wdxzf/E-Race-AutoCar-/README.md

# E-Race-AutoCar-
2024电赛自动行驶小车│电子设计大赛一等奖（湖南第三）
