wdxzf/E-Race-AutoCar-/源码/user/user/MSPM0G3507_IMU660_Demo/BSP/motor.h

#ifndef _MOTOR_H_
#define _MOTOR_H_
#include "headfile.h"

#define PulseMPS 0.014 //轮轴系数
typedef struct
{
    float Lenth;       //距离  防抖
} Step;/***************距离***************/

int16_t Speed_Get(void);
void motor_turn(int32_t speedL,int32_t speedR);

extern Step Step1;
#endif
