wdxzf/E-Race-AutoCar-/源码/user/user/MSPM0G3507_IMU660_Demo/ti_msp_dl_config.c

/*
 * Copyright (c) 2023, Texas Instruments Incorporated
 * All rights reserved.
 *
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
 * *  Redistributions of source code must retain the above copyright
 *    notice, this list of conditions and the following disclaimer.
 *
 * *  Redistributions in binary form must reproduce the above copyright
 *    notice, this list of conditions and the following disclaimer in the
 *    documentation and/or other materials provided with the distribution.
 *
 * *  Neither the name of Texas Instruments Incorporated nor the names of
 *    its contributors may be used to endorse or promote products derived
 *    from this software without specific prior written permission.
 *
 * THIS SOFTWARE IS PROVIDED BY THE COPYRIGHT HOLDERS AND CONTRIBUTORS "AS IS"
 * AND ANY EXPRESS OR IMPLIED WARRANTIES, INCLUDING, BUT NOT LIMITED TO,
 * THE IMPLIED WARRANTIES OF MERCHANTABILITY AND FITNESS FOR A PARTICULAR
 * PURPOSE ARE DISCLAIMED. IN NO EVENT SHALL THE COPYRIGHT OWNER OR
 * CONTRIBUTORS BE LIABLE FOR ANY DIRECT, INDIRECT, INCIDENTAL, SPECIAL,
 * EXEMPLARY, OR CONSEQUENTIAL DAMAGES (INCLUDING, BUT NOT LIMITED TO,
 * PROCUREMENT OF SUBSTITUTE GOODS OR SERVICES; LOSS OF USE, DATA, OR PROFITS;
 * OR BUSINESS INTERRUPTION) HOWEVER CAUSED AND ON ANY THEORY OF LIABILITY,
 * WHETHER IN CONTRACT, STRICT LIABILITY, OR TORT (INCLUDING NEGLIGENCE OR
 * OTHERWISE) ARISING IN ANY WAY OUT OF THE USE OF THIS SOFTWARE,
 * EVEN IF ADVISED OF THE POSSIBILITY OF SUCH DAMAGE.
 */

/*
 *  ============ ti_msp_dl_config.c =============
 *  Configured MSPM0 DriverLib module definitions
 *
 *  DO NOT EDIT - This file is generated for the MSPM0G350X
 *  by the SysConfig tool.
 */

#include "ti_msp_dl_config.h"

DL_SPI_backupConfig gSPI_FOR_IMUBackup;

/*
 *  ======== SYSCFG_DL_init ========
 *  Perform any initialization needed before using any board APIs
 */
SYSCONFIG_WEAK void SYSCFG_DL_init(void)
{
    SYSCFG_DL_initPower();
    SYSCFG_DL_GPIO_init();
    /* Module-Specific Initializations*/
    SYSCFG_DL_SYSCTL_init();
    SYSCFG_DL_PWM_Motor_init();
    SYSCFG_DL_TIMER_0_init();
    SYSCFG_DL_UART_0_init();
    SYSCFG_DL_SPI_FOR_IMU_init();
    SYSCFG_DL_SYSTICK_init();
    /* Ensure backup structures have no valid state */



	gSPI_FOR_IMUBackup.backupRdy 	= false;

}
/*
 * User should take care to save and restore register configuration in application.
 * See Retention Configuration section for more details.
 */
SYSCONFIG_WEAK bool SYSCFG_DL_saveConfiguration(void)
{
    bool retStatus = true;

	retStatus &= DL_SPI_saveConfiguration(SPI_FOR_IMU_INST, &gSPI_FOR_IMUBackup);

    return retStatus;
}


SYSCONFIG_WEAK bool SYSCFG_DL_restoreConfiguration(void)
{
    bool retStatus = true;

	retStatus &= DL_SPI_restoreConfiguration(SPI_FOR_IMU_INST, &gSPI_FOR_IMUBackup);

    return retStatus;
}

SYSCONFIG_WEAK void SYSCFG_DL_initPower(void)
{
    DL_GPIO_reset(GPIOA);
    DL_GPIO_reset(GPIOB);
    DL_TimerG_reset(PWM_Motor_INST);
    DL_TimerG_reset(TIMER_0_INST);
    DL_UART_Main_reset(UART_0_INST);
    DL_SPI_reset(SPI_FOR_IMU_INST);


    DL_GPIO_enablePower(GPIOA);
    DL_GPIO_enablePower(GPIOB);
    DL_TimerG_enablePower(PWM_Motor_INST);
    DL_TimerG_enablePower(TIMER_0_INST);
    DL_UART_Main_enablePower(UART_0_INST);
    DL_SPI_enablePower(SPI_FOR_IMU_INST);

    delay_cycles(POWER_STARTUP_DELAY);
}

SYSCONFIG_WEAK void SYSCFG_DL_GPIO_init(void)
{

    DL_GPIO_initPeripheralOutputFunction(GPIO_PWM_Motor_C0_IOMUX,GPIO_PWM_Motor_C0_IOMUX_FUNC);
    DL_GPIO_enableOutput(GPIO_PWM_Motor_C0_PORT, GPIO_PWM_Motor_C0_PIN);
    DL_GPIO_initPeripheralOutputFunction(GPIO_PWM_Motor_C1_IOMUX,GPIO_PWM_Motor_C1_IOMUX_FUNC);
    DL_GPIO_enableOutput(GPIO_PWM_Motor_C1_PORT, GPIO_PWM_Motor_C1_PIN);

    DL_GPIO_initPeripheralOutputFunction(
        GPIO_UART_0_IOMUX_TX, GPIO_UART_0_IOMUX_TX_FUNC);
    DL_GPIO_initPeripheralInputFunction(
        GPIO_UART_0_IOMUX_RX, GPIO_UART_0_IOMUX_RX_FUNC);

    DL_GPIO_initPeripheralOutputFunction(
        GPIO_SPI_FOR_IMU_IOMUX_SCLK, GPIO_SPI_FOR_IMU_IOMUX_SCLK_FUNC);
    DL_GPIO_initPeripheralOutputFunction(
        GPIO_SPI_FOR_IMU_IOMUX_PICO, GPIO_SPI_FOR_IMU_IOMUX_PICO_FUNC);
    DL_GPIO_initPeripheralInputFunction(
        GPIO_SPI_FOR_IMU_IOMUX_POCI, GPIO_SPI_FOR_IMU_IOMUX_POCI_FUNC);
    DL_GPIO_initPeripheralOutputFunction(
        GPIO_SPI_FOR_IMU_IOMUX_CS0, GPIO_SPI_FOR_IMU_IOMUX_CS0_FUNC);

    DL_GPIO_initDigitalOutput(SPI_FOR_IMU_CS_PIN_8_IOMUX);

    DL_GPIO_initDigitalOutput(PROTA_BEEP_IOMUX);

    DL_GPIO_initDigitalInputFeatures(KEY_key1_IOMUX,
		 DL_GPIO_INVERSION_DISABLE, DL_GPIO_RESISTOR_PULL_UP,
		 DL_GPIO_HYSTERESIS_DISABLE, DL_GPIO_WAKEUP_DISABLE);

    DL_GPIO_initDigitalInputFeatures(KEY_key2_IOMUX,
		 DL_GPIO_INVERSION_DISABLE, DL_GPIO_RESISTOR_PULL_DOWN,
		 DL_GPIO_HYSTERESIS_DISABLE, DL_GPIO_WAKEUP_DISABLE);

    DL_GPIO_initDigitalInputFeatures(KEY_key3_IOMUX,
		 DL_GPIO_INVERSION_DISABLE, DL_GPIO_RESISTOR_PULL_UP,
		 DL_GPIO_HYSTERESIS_DISABLE, DL_GPIO_WAKEUP_DISABLE);

    DL_GPIO_initDigitalInputFeatures(KEY_key4_IOMUX,
		 DL_GPIO_INVERSION_DISABLE, DL_GPIO_RESISTOR_PULL_UP,
		 DL_GPIO_HYSTERESIS_DISABLE, DL_GPIO_WAKEUP_DISABLE);

    DL_GPIO_initDigitalInputFeatures(KEY_key5_IOMUX,
		 DL_GPIO_INVERSION_DISABLE, DL_GPIO_RESISTOR_PULL_UP,
		 DL_GPIO_HYSTERESIS_DISABLE, DL_GPIO_WAKEUP_DISABLE);

    DL_GPIO_initDigitalInputFeatures(KEY_key6_IOMUX,
		 DL_GPIO_INVERSION_DISABLE, DL_GPIO_RESISTOR_PULL_UP,
		 DL_GPIO_HYSTERESIS_DISABLE, DL_GPIO_WAKEUP_DISABLE);

    DL_GPIO_initDigitalInputFeatures(KEY_key7_IOMUX,
		 DL_GPIO_INVERSION_DISABLE, DL_GPIO_RESISTOR_PULL_UP,
		 DL_GPIO_HYSTERESIS_DISABLE, DL_GPIO_WAKEUP_DISABLE);

    DL_GPIO_initDigitalInputFeatures(KEY_key8_IOMUX,
		 DL_GPIO_INVERSION_DISABLE, DL_GPIO_RESISTOR_PULL_UP,
		 DL_GPIO_HYSTERESIS_DISABLE, DL_GPIO_WAKEUP_DISABLE);

    DL_GPIO_initDigitalOutput(Motor_L2_IOMUX);

    DL_GPIO_initDigitalOutput(Motor_L1_IOMUX);

    DL_GPIO_initDigitalOutput(Motor_R1_IOMUX);

    DL_GPIO_initDigitalOutput(Motor_R2_IOMUX);

    DL_GPIO_initDigitalInputFeatures(Gray_Gray_0_IOMUX,
		 DL_GPIO_INVERSION_DISABLE, DL_GPIO_RESISTOR_PULL_UP,
		 DL_GPIO_HYSTERESIS_DISABLE, DL_GPIO_WAKEUP_DISABLE);

    DL_GPIO_initDigitalInputFeatures(Gray_Gray_1_IOMUX,
		 DL_GPIO_INVERSION_DISABLE, DL_GPIO_RESISTOR_PULL_UP,
		 DL_GPIO_HYSTERESIS_DISABLE, DL_GPIO_WAKEUP_DISABLE);

    DL_GPIO_initDigitalInputFeatures(Gray_Gray_2_IOMUX,
		 DL_GPIO_INVERSION_DISABLE, DL_GPIO_RESISTOR_PULL_UP,
		 DL_GPIO_HYSTERESIS_DISABLE, DL_GPIO_WAKEUP_DISABLE);

    DL_GPIO_initDigitalInputFeatures(Gray_Gray_3_IOMUX,
		 DL_GPIO_INVERSION_DISABLE, DL_GPIO_RESISTOR_PULL_UP,
		 DL_GPIO_HYSTERESIS_DISABLE, DL_GPIO_WAKEUP_DISABLE);

    DL_GPIO_initDigitalInputFeatures(Gray_Gray_4_IOMUX,
		 DL_GPIO_INVERSION_DISABLE, DL_GPIO_RESISTOR_PULL_UP,
		 DL_GPIO_HYSTERESIS_DISABLE, DL_GPIO_WAKEUP_DISABLE);

    DL_GPIO_initDigitalInputFeatures(Gray_Gray_5_IOMUX,
		 DL_GPIO_INVERSION_DISABLE, DL_GPIO_RESISTOR_PULL_UP,
		 DL_GPIO_HYSTERESIS_DISABLE, DL_GPIO_WAKEUP_DISABLE);

    DL_GPIO_initDigitalInputFeatures(Gray_Gray_6_IOMUX,
		 DL_GPIO_INVERSION_DISABLE, DL_GPIO_RESISTOR_PULL_UP,
		 DL_GPIO_HYSTERESIS_DISABLE, DL_GPIO_WAKEUP_DISABLE);

    DL_GPIO_initDigitalInputFeatures(Gray_Gray_7_IOMUX,
		 DL_GPIO_INVERSION_DISABLE, DL_GPIO_RESISTOR_PULL_UP,
		 DL_GPIO_HYSTERESIS_DISABLE, DL_GPIO_WAKEUP_DISABLE);

    DL_GPIO_initDigitalInputFeatures(Gray_Gray_8_IOMUX,
		 DL_GPIO_INVERSION_DISABLE, DL_GPIO_RESISTOR_PULL_UP,
		 DL_GPIO_HYSTERESIS_DISABLE, DL_GPIO_WAKEUP_DISABLE);

    DL_GPIO_initDigitalInputFeatures(Gray_Gray_9_IOMUX,
		 DL_GPIO_INVERSION_DISABLE, DL_GPIO_RESISTOR_PULL_UP,
		 DL_GPIO_HYSTERESIS_DISABLE, DL_GPIO_WAKEUP_DISABLE);

    DL_GPIO_initDigitalInputFeatures(Gray_Gray_10_IOMUX,
		 DL_GPIO_INVERSION_DISABLE, DL_GPIO_RESISTOR_PULL_UP,
		 DL_GPIO_HYSTERESIS_DISABLE, DL_GPIO_WAKEUP_DISABLE);

    DL_GPIO_initDigitalInputFeatures(Gray_Gray_11_IOMUX,
		 DL_GPIO_INVERSION_DISABLE, DL_GPIO_RESISTOR_PULL_UP,
		 DL_GPIO_HYSTERESIS_DISABLE, DL_GPIO_WAKEUP_DISABLE);

    DL_GPIO_initDigitalOutput(LED_led_r_IOMUX);

    DL_GPIO_initDigitalOutput(LED_RGB_R_IOMUX);

    DL_GPIO_initDigitalOutput(LED_RGB_G_IOMUX);

    DL_GPIO_initDigitalOutput(LED_RGB_B_IOMUX);

    DL_GPIO_initDigitalInput(ENCODERB_ELB_IOMUX);

    DL_GPIO_initDigitalInput(ENCODERB_ELA_IOMUX);

    DL_GPIO_initDigitalInput(ENCODERB_ERB_IOMUX);

    DL_GPIO_initDigitalInput(ENCODERB_ERA_IOMUX);

    DL_GPIO_clearPins(GPIOA, PROTA_BEEP_PIN);
    DL_GPIO_setPins(GPIOA, SPI_FOR_IMU_CS_PIN_8_PIN |
		LED_led_r_PIN);
    DL_GPIO_enableOutput(GPIOA, SPI_FOR_IMU_CS_PIN_8_PIN |
		PROTA_BEEP_PIN |
		LED_led_r_PIN);
    DL_GPIO_setLowerPinsPolarity(GPIOA, DL_GPIO_PIN_15_EDGE_RISE);
    DL_GPIO_setUpperPinsPolarity(GPIOA, DL_GPIO_PIN_22_EDGE_RISE |
		DL_GPIO_PIN_17_EDGE_RISE |
		DL_GPIO_PIN_16_EDGE_RISE);
    DL_GPIO_clearInterruptStatus(GPIOA, ENCODERB_ELB_PIN |
		ENCODERB_ELA_PIN |
		ENCODERB_ERB_PIN |
		ENCODERB_ERA_PIN);
    DL_GPIO_enableInterrupt(GPIOA, ENCODERB_ELB_PIN |
		ENCODERB_ELA_PIN |
		ENCODERB_ERB_PIN |
		ENCODERB_ERA_PIN);
    DL_GPIO_clearPins(GPIOB, Motor_L2_PIN |
		Motor_L1_PIN |
		Motor_R1_PIN |
		Motor_R2_PIN |
		LED_RGB_R_PIN |
		LED_RGB_G_PIN |
		LED_RGB_B_PIN);
    DL_GPIO_enableOutput(GPIOB, Motor_L2_PIN |
		Motor_L1_PIN |
		Motor_R1_PIN |
		Motor_R2_PIN |
		LED_RGB_R_PIN |
		LED_RGB_G_PIN |
		LED_RGB_B_PIN);
    DL_GPIO_setUpperPinsPolarity(GPIOB, DL_GPIO_PIN_21_EDGE_RISE);
    DL_GPIO_clearInterruptStatus(GPIOB, KEY_key1_PIN);
    DL_GPIO_enableInterrupt(GPIOB, KEY_key1_PIN);

}



SYSCONFIG_WEAK void SYSCFG_DL_SYSCTL_init(void)
{

	//Low Power Mode is configured to be SLEEP0
    DL_SYSCTL_setBORThreshold(DL_SYSCTL_BOR_THRESHOLD_LEVEL_0);

    
	DL_SYSCTL_setSYSOSCFreq(DL_SYSCTL_SYSOSC_FREQ_BASE);
	/* Set default configuration */
	DL_SYSCTL_disableHFXT();
	DL_SYSCTL_disableSYSPLL();
    DL_SYSCTL_enableMFCLK();

}


/*
 * Timer clock configuration to be sourced by  / 1 (32000000 Hz)
 * timerClkFreq = (timerClkSrc / (timerClkDivRatio * (timerClkPrescale + 1)))
 *   32000000 Hz = 32000000 Hz / (1 * (0 + 1))
 */
static const DL_TimerG_ClockConfig gPWM_MotorClockConfig = {
    .clockSel = DL_TIMER_CLOCK_BUSCLK,
    .divideRatio = DL_TIMER_CLOCK_DIVIDE_1,
    .prescale = 0U
};

static const DL_TimerG_PWMConfig gPWM_MotorConfig = {
    .pwmMode = DL_TIMER_PWM_MODE_EDGE_ALIGN_UP,
    .period = 3200,
    .startTimer = DL_TIMER_STOP,
};

SYSCONFIG_WEAK void SYSCFG_DL_PWM_Motor_init(void) {

    DL_TimerG_setClockConfig(
        PWM_Motor_INST, (DL_TimerG_ClockConfig *) &gPWM_MotorClockConfig);

    DL_TimerG_initPWMMode(
        PWM_Motor_INST, (DL_TimerG_PWMConfig *) &gPWM_MotorConfig);

    DL_TimerG_setCaptureCompareOutCtl(PWM_Motor_INST, DL_TIMER_CC_OCTL_INIT_VAL_LOW,
		DL_TIMER_CC_OCTL_INV_OUT_DISABLED, DL_TIMER_CC_OCTL_SRC_FUNCVAL,
		DL_TIMERG_CAPTURE_COMPARE_0_INDEX);

    DL_TimerG_setCaptCompUpdateMethod(PWM_Motor_INST, DL_TIMER_CC_UPDATE_METHOD_IMMEDIATE, DL_TIMERG_CAPTURE_COMPARE_0_INDEX);
    DL_TimerG_setCaptureCompareValue(PWM_Motor_INST, 319, DL_TIMER_CC_0_INDEX);

    DL_TimerG_setCaptureCompareOutCtl(PWM_Motor_INST, DL_TIMER_CC_OCTL_INIT_VAL_LOW,
		DL_TIMER_CC_OCTL_INV_OUT_DISABLED, DL_TIMER_CC_OCTL_SRC_FUNCVAL,
		DL_TIMERG_CAPTURE_COMPARE_1_INDEX);

    DL_TimerG_setCaptCompUpdateMethod(PWM_Motor_INST, DL_TIMER_CC_UPDATE_METHOD_IMMEDIATE, DL_TIMERG_CAPTURE_COMPARE_1_INDEX);
    DL_TimerG_setCaptureCompareValue(PWM_Motor_INST, 639, DL_TIMER_CC_1_INDEX);

    DL_TimerG_enableClock(PWM_Motor_INST);


    
    DL_TimerG_setCCPDirection(PWM_Motor_INST , DL_TIMER_CC0_OUTPUT | DL_TIMER_CC1_OUTPUT );


}



/*
 * Timer clock configuration to be sourced by BUSCLK /  (4000000 Hz)
 * timerClkFreq = (timerClkSrc / (timerClkDivRatio * (timerClkPrescale + 1)))
 *   4000000 Hz = 4000000 Hz / (8 * (0 + 1))
 */
static const DL_TimerG_ClockConfig gTIMER_0ClockConfig = {
    .clockSel    = DL_TIMER_CLOCK_BUSCLK,
    .divideRatio = DL_TIMER_CLOCK_DIVIDE_8,
    .prescale    = 0U,
};

/*
 * Timer load value (where the counter starts from) is calculated as (timerPeriod * timerClockFreq) - 1
 * TIMER_0_INST_LOAD_VALUE = (10ms * 4000000 Hz) - 1
 */
static const DL_TimerG_TimerConfig gTIMER_0TimerConfig = {
    .period     = TIMER_0_INST_LOAD_VALUE,
    .timerMode  = DL_TIMER_TIMER_MODE_PERIODIC,
    .startTimer = DL_TIMER_STOP,
};

SYSCONFIG_WEAK void SYSCFG_DL_TIMER_0_init(void) {

    DL_TimerG_setClockConfig(TIMER_0_INST,
        (DL_TimerG_ClockConfig *) &gTIMER_0ClockConfig);

    DL_TimerG_initTimerMode(TIMER_0_INST,
        (DL_TimerG_TimerConfig *) &gTIMER_0TimerConfig);
    DL_TimerG_enableInterrupt(TIMER_0_INST , DL_TIMERG_INTERRUPT_ZERO_EVENT);
    DL_TimerG_enableClock(TIMER_0_INST);





}



static const DL_UART_Main_ClockConfig gUART_0ClockConfig = {
    .clockSel    = DL_UART_MAIN_CLOCK_MFCLK,
    .divideRatio = DL_UART_MAIN_CLOCK_DIVIDE_RATIO_1
};

static const DL_UART_Main_Config gUART_0Config = {
    .mode        = DL_UART_MAIN_MODE_NORMAL,
    .direction   = DL_UART_MAIN_DIRECTION_TX_RX,
    .flowControl = DL_UART_MAIN_FLOW_CONTROL_NONE,
    .parity      = DL_UART_MAIN_PARITY_NONE,
    .wordLength  = DL_UART_MAIN_WORD_LENGTH_8_BITS,
    .stopBits    = DL_UART_MAIN_STOP_BITS_ONE
};

SYSCONFIG_WEAK void SYSCFG_DL_UART_0_init(void)
{
    DL_UART_Main_setClockConfig(UART_0_INST, (DL_UART_Main_ClockConfig *) &gUART_0ClockConfig);

    DL_UART_Main_init(UART_0_INST, (DL_UART_Main_Config *) &gUART_0Config);
    /*
     * Configure baud rate by setting oversampling and baud rate divisors.
     *  Target baud rate: 115200
     *  Actual baud rate: 115107.91
     */
    DL_UART_Main_setOversampling(UART_0_INST, DL_UART_OVERSAMPLING_RATE_16X);
    DL_UART_Main_setBaudRateDivisor(UART_0_INST, UART_0_IBRD_4_MHZ_115200_BAUD, UART_0_FBRD_4_MHZ_115200_BAUD);


    /* Configure Interrupts */
    DL_UART_Main_enableInterrupt(UART_0_INST,
                                 DL_UART_MAIN_INTERRUPT_RX);
    /* Setting the Interrupt Priority */
    NVIC_SetPriority(UART_0_INST_INT_IRQN, 1);


    DL_UART_Main_enable(UART_0_INST);
}

static const DL_SPI_Config gSPI_FOR_IMU_config = {
    .mode        = DL_SPI_MODE_CONTROLLER,
    .frameFormat = DL_SPI_FRAME_FORMAT_MOTO4_POL0_PHA0,
    .parity      = DL_SPI_PARITY_NONE,
    .dataSize    = DL_SPI_DATA_SIZE_8,
    .bitOrder    = DL_SPI_BIT_ORDER_MSB_FIRST,
    .chipSelectPin = DL_SPI_CHIP_SELECT_0,
};

static const DL_SPI_ClockConfig gSPI_FOR_IMU_clockConfig = {
    .clockSel    = DL_SPI_CLOCK_BUSCLK,
    .divideRatio = DL_SPI_CLOCK_DIVIDE_RATIO_1
};

SYSCONFIG_WEAK void SYSCFG_DL_SPI_FOR_IMU_init(void) {
    DL_SPI_setClockConfig(SPI_FOR_IMU_INST, (DL_SPI_ClockConfig *) &gSPI_FOR_IMU_clockConfig);

    DL_SPI_init(SPI_FOR_IMU_INST, (DL_SPI_Config *) &gSPI_FOR_IMU_config);

    /* Configure Controller mode */
    /*
     * Set the bit rate clock divider to generate the serial output clock
     *     outputBitRate = (spiInputClock) / ((1 + SCR) * 2)
     *     5333333.33 = (32000000)/((1 + 2) * 2)
     */
    DL_SPI_setBitRateSerialClockDivider(SPI_FOR_IMU_INST, 2);
    /* Set RX and TX FIFO threshold levels */
    DL_SPI_setFIFOThreshold(SPI_FOR_IMU_INST, DL_SPI_RX_FIFO_LEVEL_1_2_FULL, DL_SPI_TX_FIFO_LEVEL_1_2_EMPTY);

    /* Enable module */
    DL_SPI_enable(SPI_FOR_IMU_INST);
}

SYSCONFIG_WEAK void SYSCFG_DL_SYSTICK_init(void)
{
    /* Initialize the period to 1.00 μs */
    DL_SYSTICK_init(32);
    /* Enable the SysTick and start counting */
    DL_SYSTICK_enable();
}
