wdxzf/E-Race-AutoCar-/源码/user/user/MSPM0G3507_IMU660_Demo/zf_device/zf_device_imu660ra.c

/*********************************************************************************************************************
* MSPM0G3507 Opensourec Library 即（MSPM0G3507 开源库）是一个基于官方 SDK 接口的第三方开源库
* Copyright (c) 2022 SEEKFREE 逐飞科技
* 
* 本文件是 MSPM0G3507 开源库的一部分
* 
* MSPM0G3507 开源库 是免费软件
* 您可以根据自由软件基金会发布的 GPL（GNU General Public License，即 GNU通用公共许可证）的条款
* 即 GPL 的第3版（即 GPL3.0）或（您选择的）任何后来的版本，重新发布和/或修改它
* 
* 本开源库的发布是希望它能发挥作用，但并未对其作任何的保证
* 甚至没有隐含的适销性或适合特定用途的保证
* 更多细节请参见 GPL
* 
* 您应该在收到本开源库的同时收到一份 GPL 的副本
* 如果没有，请参阅<https://www.gnu.org/licenses/>
* 
* 额外注明：
* 本开源库使用 GPL3.0 开源许可证协议 以上许可申明为译文版本
* 许可申明英文版在 libraries/doc 文件夹下的 GPL3_permission_statement.txt 文件中
* 许可证副本在 libraries 文件夹下 即该文件夹下的 LICENSE 文件
* 欢迎各位使用并传播本程序 但修改内容时必须保留逐飞科技的版权声明（即本声明）
* 
* 文件名称          zf_device_imu660ra
* 公司名称          成都逐飞科技有限公司
* 版本信息          查看 libraries/doc 文件夹内 version 文件 版本说明
* 开发环境          MDK 5.38a
* 适用平台          MSPM0G3507
* 店铺链接          https://seekfree.taobao.com/
********************************************************************************************************************/

/*********************************************************************************************************************
* 接线定义          查看 zf_device_imu_interface.h 中接口资源定义
********************************************************************************************************************/

// zf_device 层头文件引用
#include "zf_device_imu_interface.h"

// 自身头文件
#include "zf_device_imu660ra.h"

const unsigned char imu660ra_config_file[8192];
imu660ra_measurement_data_struct acc_data, gyro_data;
// 此处定义 本文件的所有函数具体定义 这里不允许用户修改
// >>>>>>>>>>>>>>>>>>>>>>>>>>>>>>>>>>>>>>>>> Part Start >>>>>>>>>>>>>>>>>>>>>>>>>>>>>>>>>>>>>>>>>
//-------------------------------------------------------------------------------------------------------------------
// 函数简介     获取 IMU660RA 加速度计数据 拓展接口
// 参数说明     *interface              IMU660RA 的通信接口对象指针
// 参数说明     *measurement_data       IMU660RA 的测量数据缓冲指针
// 返回参数     imu660ra_state_enum     IMU660RA 状态码 详见 zf_device_imu660ra.h 中 imu660ra_state_enum 定义
// 使用示例     imu660ra_expansion_get_acc(interface, data_buffer);
// 备注信息     本接口为传感器框架接口 并不直接对用户开放
//-------------------------------------------------------------------------------------------------------------------
static imu660ra_state_enum imu660ra_expansion_get_acc (imu_interface_obj_struct *interface, imu660ra_measurement_data_struct *measurement_data)
{
    imu660ra_state_enum return_state = IMU660RA_STATE_NO_ERROR;
    do{
        if( interface->assert(
                NULL != measurement_data,                                       // 缓冲区指针 不能为空
                "*measurement_data error.",                                     // 输出预设报错信息
                ZF_FILE_MESSAGE, ZF_LINE_MESSAGE))
        {
            return_state = IMU660RA_STATE_DATA_BUFFER_ERROR;
            break;
        }
        uint8 data[8];
        if(IMU_INTERFACE_SPI == interface->interface_type)
        {
            interface->read_8bit_registers(IMU660RA_DEV_ADDR, IMU660RA_ACC_ADDRESS | IMU660RA_SPI_R, data, 7);
        }
        else
        {
            interface->read_8bit_registers(IMU660RA_DEV_ADDR, IMU660RA_ACC_ADDRESS, &data[1], 6);
        }
        measurement_data->x = (int16)(((uint16)data[2] << 8 | data[1]));
        measurement_data->y = (int16)(((uint16)data[4] << 8 | data[3]));
        measurement_data->z = (int16)(((uint16)data[6] << 8 | data[5]));
    }while(0);
    return return_state;
}

//-------------------------------------------------------------------------------------------------------------------
// 函数简介     获取 IMU660RA 陀螺仪数据 拓展接口
// 参数说明     *interface              IMU660RA 的通信接口对象指针
// 参数说明     *measurement_data       IMU660RA 的测量数据缓冲指针
// 返回参数     imu660ra_state_enum     IMU660RA 状态码 详见 zf_device_imu660ra.h 中 imu660ra_state_enum 定义
// 使用示例     imu660ra_expansion_get_gyro(interface, data_buffer);
// 备注信息     本接口为传感器框架接口 并不直接对用户开放
//-------------------------------------------------------------------------------------------------------------------
static imu660ra_state_enum imu660ra_expansion_get_gyro (imu_interface_obj_struct *interface, imu660ra_measurement_data_struct *measurement_data)
{
    imu660ra_state_enum return_state = IMU660RA_STATE_NO_ERROR;
    do{
        if( interface->assert(
                NULL != measurement_data,                                       // 缓冲区指针 不能为空
                "*measurement_data error.",                                     // 输出预设报错信息
                ZF_FILE_MESSAGE, ZF_LINE_MESSAGE))
        {
            return_state = IMU660RA_STATE_DATA_BUFFER_ERROR;
            break;
        }
        uint8 data[8];
        if(IMU_INTERFACE_SPI == interface->interface_type)
        {
            interface->read_8bit_registers(IMU660RA_DEV_ADDR, IMU660RA_GYRO_ADDRESS | IMU660RA_SPI_R, data, 7);
        }
        else
        {
            interface->read_8bit_registers(IMU660RA_DEV_ADDR, IMU660RA_GYRO_ADDRESS, &data[1], 6);
        }
        //measurement_data->x = (int16)(((uint16)data[2] << 8 | data[1]));
        //measurement_data->y = (int16)(((uint16)data[4] << 8 | data[3]));
        measurement_data->z = (int16)(((uint16)data[6] << 8 | data[5]));
    }while(0);
    return return_state;
}

//-------------------------------------------------------------------------------------------------------------------
// 函数简介     IMU660RA 配置模块工作参数 拓展接口
// 参数说明     *interface              IMU660RA 的通信接口对象指针
// 参数说明     item                    IMU660RA 配置参照 zf_device_imu660ra.h 中 imu660ra_config_item_enum 枚举体定义
// 返回参数     imu660ra_state_enum     IMU660RA 状态码 详见 zf_device_imu660ra.h 中 imu660ra_state_enum 定义
// 使用示例     imu660ra_expansion_set_config(interface, item);
// 备注信息     本接口为传感器框架接口 并不直接对用户开放
//-------------------------------------------------------------------------------------------------------------------
static imu660ra_state_enum imu660ra_expansion_set_config (imu_interface_obj_struct *interface, imu660ra_config_item_enum item)
{
    imu660ra_state_enum return_state = IMU660RA_STATE_NO_ERROR;
    do{
        switch((item >> IMU660RA_CONFIG_TYPE_OFFSET) & IMU660RA_CONFIG_TYPE_MASK)
        {
            case 0x00:
            {
                if( interface->assert(
                            IMU660RA_ACC_OUTPUT_RATE_64_DIV     <= (item & 0x0F)
                        &&  IMU660RA_ACC_OUTPUT_RATE_32_MUL     >= (item & 0x0F),
                        "item set error.",                                      // 输出预设报错信息
                        ZF_FILE_MESSAGE, ZF_LINE_MESSAGE))
                {
                    return_state = IMU660RA_STATE_SET_ACC_OUTPUT_RATE_ERROR;
                    break;
                }
                interface->write_8bit_register(IMU660RA_DEV_ADDR, IMU660RA_ACC_CONF, 0xA0 | ((item & 0x0F) - 1));
            }break;
            case 0x01:
            {
                if( interface->assert(
                            IMU660RA_ACC_RANGE_SGN_2G <= (item & 0x0F)
                        &&  IMU660RA_ACC_RANGE_SGN_16G >= (item & 0x0F),
                        "item set error.",                                      // 输出预设报错信息
                        ZF_FILE_MESSAGE, ZF_LINE_MESSAGE))
                {
                    return_state = IMU660RA_STATE_SET_ACC_RANGE_ERROR;
                    break;
                }
                interface->write_8bit_register(IMU660RA_DEV_ADDR, IMU660RA_ACC_RANGE, (item & 0x0F) - 2);
            }break;
            case 0x02:
            {
                if( interface->assert(
                            IMU660RA_GYRO_OUTPUT_RATE_2_DIV     <= (item & 0x0F)
                        &&  IMU660RA_GYRO_OUTPUT_RATE_64_MUL    >= (item & 0x0F),
                        "item set error.",                                      // 输出预设报错信息
                        ZF_FILE_MESSAGE, ZF_LINE_MESSAGE))
                {
                    return_state = IMU660RA_STATE_SET_GYRO_OUTPUT_RATE_ERROR;
                    break;
                }
                interface->write_8bit_register(IMU660RA_DEV_ADDR, IMU660RA_GYR_CONF, 0xA0 | ((item & 0x0F) - 1));
            }break;
            case 0x03:
            {
                if( interface->assert(
                            IMU660RA_GYRO_RANGE_SGN_125DPS  <= (item & 0x0F)
                        &&  IMU660RA_GYRO_RANGE_SGN_2000DPS >= (item & 0x0F),
                        "item set error.",                                      // 输出预设报错信息
                        ZF_FILE_MESSAGE, ZF_LINE_MESSAGE))
                {
                    return_state = IMU660RA_STATE_SET_GYRO_RANGE_ERROR;
                    break;
                }
                interface->write_8bit_register(IMU660RA_DEV_ADDR, IMU660RA_GYR_RANGE, 6 - (item & 0x0F));
            }break;
            default:
            {
                if( interface->assert(
                        0,
                        "item set error.",                                      // 输出预设报错信息
                        ZF_FILE_MESSAGE, ZF_LINE_MESSAGE))
                {
                    return_state = IMU660RA_STATE_SET_CONFIG_ERROR;
                    break;
                }
            }break;
        }
    }while(0);
    return return_state;
}

//-------------------------------------------------------------------------------------------------------------------
// 函数简介     IMU660RA 检测 ID 是否匹配 拓展接口
// 参数说明     *interface              IMU660RA 的通信接口对象指针
// 返回参数     imu660ra_state_enum     IMU660RA 状态码 详见 zf_device_imu660ra.h 中 imu660ra_state_enum 定义
// 使用示例     imu660ra_expansion_ckeck_id(interface);
// 备注信息     本接口为传感器框架接口 并不直接对用户开放
//-------------------------------------------------------------------------------------------------------------------
static imu660ra_state_enum imu660ra_expansion_ckeck_id (imu_interface_obj_struct *interface)
{
    imu660ra_state_enum return_state = IMU660RA_STATE_NO_ERROR;
    uint8 dat[2];
    uint16 timeout_count = 0;
    do
    {
        if(IMU660RA_TIMEOUT_COUNT < timeout_count ++)
        {
            return_state =  IMU660RA_STATE_ID_CHECK_ERROR;
            break;
        }
        if(IMU_INTERFACE_SPI == interface->interface_type)
        {
            interface->read_8bit_registers(IMU660RA_DEV_ADDR, IMU660RA_CHIP_ID | IMU660RA_SPI_R, dat, 2);
        }
        else
        {
            dat[1] = interface->read_8bit_register(IMU660RA_DEV_ADDR, IMU660RA_CHIP_ID);
        }
        interface->delay_ms(1);
    }while(0x24 != dat[1]);
    return return_state;
}

//-------------------------------------------------------------------------------------------------------------------
// 函数简介     初始化 IMU660RA 拓展接口
// 参数说明     *interface              IMU660RA 的通信接口对象指针
// 返回参数     imu660ra_state_enum     IMU660RA 状态码 详见 zf_device_imu660ra.h 中 imu660ra_state_enum 定义
// 使用示例     imu660ra_expansion_init(interface);
// 备注信息     本接口为传感器框架接口 并不直接对用户开放
//-------------------------------------------------------------------------------------------------------------------
static imu660ra_state_enum imu660ra_expansion_init (imu_interface_obj_struct *interface)
{
    imu660ra_state_enum return_state = IMU660RA_STATE_NO_ERROR;
    do{
        interface->write_8bit_register(IMU660RA_DEV_ADDR, IMU660RA_PWR_CONF, 0x00);     // 关闭高级省电模式
        interface->delay_ms(1);
        interface->write_8bit_register(IMU660RA_DEV_ADDR, IMU660RA_INIT_CTRL, 0x00);    // 开始对模块进行初始化配置
        interface->write_8bit_registers(IMU660RA_DEV_ADDR, IMU660RA_INIT_DATA, imu660ra_config_file, sizeof(imu660ra_config_file));
        interface->write_8bit_register(IMU660RA_DEV_ADDR, IMU660RA_INIT_CTRL, 0x01);    // 初始化配置结束
        interface->delay_ms(20);

        uint8 data[2] = {0, 0};
        if(IMU_INTERFACE_SPI == interface->interface_type)
        {
            interface->read_8bit_registers(IMU660RA_DEV_ADDR, IMU660RA_INT_STA | IMU660RA_SPI_R, data, 2);
        }
        else
        {
            data[1] = interface->read_8bit_register(IMU660RA_DEV_ADDR, IMU660RA_INT_STA);
        }
        if( interface->assert(
                1 == data[1],                                                   // 检查是否配置完成
                "imu660ra config error.",                                       // 输出预设报错信息
                ZF_FILE_MESSAGE, ZF_LINE_MESSAGE))
        {
            return_state = IMU660RA_STATE_SET_CONFIG_ERROR;
            break;
        }

        // 开启性能模式  使能陀螺仪、加速度、温度传感器
        interface->write_8bit_register(IMU660RA_DEV_ADDR, IMU660RA_PWR_CTRL, 0x0E);

        if( interface->assert(
                    IMU660RA_ACC_OUTPUT_RATE_64_DIV <= IMU660RA_ACC_OUTPUT_RATE_DEFAULT
                &&  IMU660RA_ACC_OUTPUT_RATE_32_MUL >= IMU660RA_ACC_OUTPUT_RATE_DEFAULT,
                "IMU660RA_ACC_SAMPLE_RATE_DEFAULT set error.",                  // 输出预设报错信息
                ZF_FILE_MESSAGE, ZF_LINE_MESSAGE))
        {
            return_state = IMU660RA_STATE_SET_ACC_OUTPUT_RATE_ERROR;
            break;
        }
        interface->write_8bit_register(IMU660RA_DEV_ADDR, IMU660RA_ACC_CONF, 0xA0 | (IMU660RA_ACC_OUTPUT_RATE_DEFAULT - 1));

        if( interface->assert(
                    IMU660RA_GYRO_OUTPUT_RATE_2_DIV     <= IMU660RA_GYRO_OUTPUT_RATE_DEFAULT
                &&  IMU660RA_GYRO_OUTPUT_RATE_64_MUL    >= IMU660RA_GYRO_OUTPUT_RATE_DEFAULT,
                "IMU660RA_GYRO_SAMPLE_RATE_DEFAULT set error.",                 // 输出预设报错信息
                ZF_FILE_MESSAGE, ZF_LINE_MESSAGE))
        {
            return_state = IMU660RA_STATE_SET_GYRO_OUTPUT_RATE_ERROR;
            break;
        }
        interface->write_8bit_register(IMU660RA_DEV_ADDR, IMU660RA_GYR_CONF, 0xA0 | (IMU660RA_GYRO_OUTPUT_RATE_DEFAULT - 1));

        // IMU660RA_ACC_RANGE 寄存器
        // 设置为 0x00 加速度计量程为 ±2  g
        // 设置为 0x01 加速度计量程为 ±4  g
        // 设置为 0x02 加速度计量程为 ±8  g
        // 设置为 0x03 加速度计量程为 ±16 g
        if( interface->assert(
                    IMU660RA_ACC_RANGE_SGN_2G       <= IMU660RA_ACC_RANGE_DEFAULT
                &&  IMU660RA_ACC_RANGE_SGN_16G      >= IMU660RA_ACC_RANGE_DEFAULT,
                "IMU660RA_ACC_RANGE_DEFAULT set error.",                        // 输出预设报错信息
                ZF_FILE_MESSAGE, ZF_LINE_MESSAGE))
        {
            return_state = IMU660RA_STATE_SET_ACC_RANGE_ERROR;
            break;
        }
        interface->write_8bit_register(IMU660RA_DEV_ADDR, IMU660RA_ACC_RANGE, IMU660RA_ACC_RANGE_DEFAULT - 2);

        // IMU660RA_GYR_RANGE 寄存器
        // 设置为 0x04 陀螺仪量程为 ±125  dps
        // 设置为 0x03 陀螺仪量程为 ±250  dps
        // 设置为 0x02 陀螺仪量程为 ±500  dps
        // 设置为 0x01 陀螺仪量程为 ±1000 dps
        // 设置为 0x00 陀螺仪量程为 ±2000 dps
        if( interface->assert(
                    IMU660RA_GYRO_RANGE_SGN_125DPS      <= IMU660RA_GYRO_RANGE_DEFAULT
                &&  IMU660RA_GYRO_RANGE_SGN_2000DPS     >= IMU660RA_GYRO_RANGE_DEFAULT,
                "IMU660RA_GYRO_RANGE_DEFAULT set error.",                       // 输出预设报错信息
                ZF_FILE_MESSAGE, ZF_LINE_MESSAGE))
        {
            return_state = IMU660RA_STATE_SET_GYRO_RANGE_ERROR;
            break;
        }
        interface->write_8bit_register(IMU660RA_DEV_ADDR, IMU660RA_GYR_RANGE, 6 - IMU660RA_GYRO_RANGE_DEFAULT);
    }while(0);
    return return_state;
}

//-------------------------------------------------------------------------------------------------------------------
// 函数简介     获取 IMU660RA 加速度计物理量数据
// 参数说明     *measurement_data       IMU660RA 的测量数据缓冲指针
// 返回参数     range                   IMU660RA 加速度量程 详见 zf_device_imu660ra.h 中 imu660ra_acc_range_enum 定义
// 参数说明     *physical_data          IMU660RA 的物理量数据缓冲指针
// 返回参数     imu660ra_state_enum     IMU660RA 状态码 详见 zf_device_imu660ra.h 中 imu660ra_state_enum 定义
// 使用示例     imu660ra_get_physical_acc(imu660_data_buffer, range, physical_data);
// 备注信息     根据量程进行物理量换算
//              加速度计量程 ±2  g   获取到的加速度计数据除以 16384  可以转化为带物理单位的数据 (g 代表重力加速度 物理学名词 一般情况下 g 取 9.8 m/s^2 为标准值)
//              加速度计量程 ±4  g   获取到的加速度计数据除以 8192   可以转化为带物理单位的数据 (g 代表重力加速度 物理学名词 一般情况下 g 取 9.8 m/s^2 为标准值)
//              加速度计量程 ±8  g   获取到的加速度计数据除以 4096   可以转化为带物理单位的数据 (g 代表重力加速度 物理学名词 一般情况下 g 取 9.8 m/s^2 为标准值)
//              加速度计量程 ±16 g   获取到的加速度计数据除以 2048   可以转化为带物理单位的数据 (g 代表重力加速度 物理学名词 一般情况下 g 取 9.8 m/s^2 为标准值)
//-------------------------------------------------------------------------------------------------------------------
imu660ra_state_enum imu660ra_get_physical_acc (imu660ra_measurement_data_struct *measurement_data, imu660ra_acc_range_enum range,imu660ra_physical_data_struct *physical_data)
{
    imu660ra_state_enum return_state = IMU660RA_STATE_NO_ERROR;
    do{
        if( imu_assert(
                NULL != measurement_data,                                       // 缓冲区指针 不能为空
                "*measurement_data error.",                                     // 输出预设报错信息
                ZF_FILE_MESSAGE, ZF_LINE_MESSAGE))
        {
            return_state = IMU660RA_STATE_DATA_BUFFER_ERROR;
            break;
        }
        if( imu_assert(
                    IMU660RA_ACC_RANGE_SGN_2G   <= range
                &&  IMU660RA_ACC_RANGE_SGN_16G  >= range,
                "range error.",                                                 // 输出预设报错信息
                ZF_FILE_MESSAGE, ZF_LINE_MESSAGE))
        {
            return_state = IMU660RA_STATE_SET_ACC_RANGE_ERROR;
            break;
        }
        if( imu_assert(
                NULL != physical_data,                                          // 缓冲区指针 不能为空
                "*physical_data error.",                                        // 输出预设报错信息
                ZF_FILE_MESSAGE, ZF_LINE_MESSAGE))
        {
            return_state = IMU660RA_STATE_DATA_BUFFER_ERROR;
            break;
        }
        const float transition_factor[] = {16384, 8192, 4096, 2048};
        physical_data->x  = (float)measurement_data->x / transition_factor[range - IMU660RA_ACC_RANGE_SGN_2G];
        physical_data->y  = (float)measurement_data->y / transition_factor[range - IMU660RA_ACC_RANGE_SGN_2G];
        physical_data->z  = (float)measurement_data->z / transition_factor[range - IMU660RA_ACC_RANGE_SGN_2G];
    }while(0);
    return return_state;
}

//-------------------------------------------------------------------------------------------------------------------
// 函数简介     获取 IMU660RA 陀螺仪物理量数据
// 参数说明     *measurement_data       IMU660RA 的测量数据缓冲指针
// 返回参数     range                   IMU660RA 加速度量程 详见 zf_device_imu660ra.h 中 imu660ra_gyro_range_enum 定义
// 参数说明     *physical_data          IMU660RA 的物理量数据缓冲指针
// 返回参数     imu660ra_state_enum     IMU660RA 状态码 详见 zf_device_imu660ra.h 中 imu660ra_state_enum 定义
// 使用示例     imu660ra_get_physical_gyro(imu660_data_buffer, range, physical_data);
// 备注信息     根据量程进行物理量换算
//              陀螺仪量程 ±125  dps    获取到的陀螺仪数据除以 262.144  可以转化为带物理单位的数据 单位为 °/s
//              陀螺仪量程 ±250  dps    获取到的陀螺仪数据除以 131.072  可以转化为带物理单位的数据 单位为 °/s
//              陀螺仪量程 ±500  dps    获取到的陀螺仪数据除以  65.536  可以转化为带物理单位的数据 单位为 °/s
//              陀螺仪量程 ±1000 dps    获取到的陀螺仪数据除以  32.768  可以转化为带物理单位的数据 单位为 °/s
//              陀螺仪量程 ±2000 dps    获取到的陀螺仪数据除以  16.384  可以转化为带物理单位的数据 单位为 °/s
//-------------------------------------------------------------------------------------------------------------------
imu660ra_state_enum imu660ra_get_physical_gyro (imu660ra_measurement_data_struct *measurement_data, imu660ra_gyro_range_enum range,imu660ra_physical_data_struct *physical_data)
{
    imu660ra_state_enum return_state = IMU660RA_STATE_NO_ERROR;
    do{
        if( imu_assert(
                NULL != measurement_data,                                       // 缓冲区指针 不能为空
                "*measurement_data error.",                                     // 输出预设报错信息
                ZF_FILE_MESSAGE, ZF_LINE_MESSAGE))
        {
            return_state = IMU660RA_STATE_DATA_BUFFER_ERROR;
            break;
        }
        if( imu_assert(
                    IMU660RA_GYRO_RANGE_SGN_125DPS  <= range
                &&  IMU660RA_GYRO_RANGE_SGN_2000DPS >= range,
                "range error.",                                                 // 输出预设报错信息
                ZF_FILE_MESSAGE, ZF_LINE_MESSAGE))
        {
            return_state = IMU660RA_STATE_SET_GYRO_RANGE_ERROR;
            break;
        }
        if( imu_assert(
                NULL != physical_data,                                          // 缓冲区指针 不能为空
                "*physical_data error.",                                        // 输出预设报错信息
                ZF_FILE_MESSAGE, ZF_LINE_MESSAGE))
        {
            return_state = IMU660RA_STATE_DATA_BUFFER_ERROR;
            break;
        }
        const float transition_factor[] = {262.144, 131.072, 65.536, 32.768, 16.384};
        physical_data->x  = (float)measurement_data->x / transition_factor[range - IMU660RA_GYRO_RANGE_SGN_125DPS];
        physical_data->y  = (float)measurement_data->y / transition_factor[range - IMU660RA_GYRO_RANGE_SGN_125DPS];
        physical_data->z  = (float)measurement_data->z / transition_factor[range - IMU660RA_GYRO_RANGE_SGN_125DPS];
    }while(0);
    return return_state;
}

//-------------------------------------------------------------------------------------------------------------------
// 函数简介     获取 IMU660RA 加速度计数据
// 参数说明     *measurement_data       IMU660RA 的测量数据缓冲指针
// 返回参数     imu660ra_state_enum     IMU660RA 状态码 详见 zf_device_imu660ra.h 中 imu660ra_state_enum 定义
// 使用示例     imu660ra_get_acc(imu660_data_buffer);
// 备注信息     
//-------------------------------------------------------------------------------------------------------------------
imu660ra_state_enum imu660ra_get_acc (imu660ra_measurement_data_struct *measurement_data)
{
    return imu660ra_expansion_get_acc(&imu_interface_default_obj, measurement_data);
}

//-------------------------------------------------------------------------------------------------------------------
// 函数简介     获取 IMU660RA 陀螺仪数据
// 参数说明     *measurement_data       IMU660RA 的测量数据缓冲指针
// 返回参数     imu660ra_state_enum     IMU660RA 状态码 详见 zf_device_imu660ra.h 中 imu660ra_state_enum 定义
// 使用示例     imu660ra_get_gyro(imu660_data_buffer);
// 备注信息     
//-------------------------------------------------------------------------------------------------------------------
imu660ra_state_enum imu660ra_get_gyro (imu660ra_measurement_data_struct *measurement_data)
{
    return imu660ra_expansion_get_gyro(&imu_interface_default_obj, measurement_data);
}

//-------------------------------------------------------------------------------------------------------------------
// 函数简介     IMU660RA 配置模块工作参数
// 参数说明     item                    IMU660RA 配置参照 zf_device_imu660ra.h 中 imu660ra_config_item_enum 枚举体定义
// 返回参数     imu660ra_state_enum     IMU660RA 状态码 详见 zf_device_imu660ra.h 中 imu660ra_state_enum 定义
// 使用示例     imu660ra_set_config(item);
// 备注信息
//-------------------------------------------------------------------------------------------------------------------
imu660ra_state_enum imu660ra_set_config (imu660ra_config_item_enum item)
{
    return imu660ra_expansion_set_config(&imu_interface_default_obj, item);
}

//-------------------------------------------------------------------------------------------------------------------
// 函数简介     初始化 IMU660RA
// 参数说明     void
// 返回参数     imu660ra_state_enum     IMU660RA 状态码 详见 zf_device_imu660ra.h 中 imu660ra_state_enum 定义
// 使用示例     imu660ra_init();
// 备注信息
//-------------------------------------------------------------------------------------------------------------------
imu660ra_state_enum imu660ra_init (void)
{
    imu660ra_state_enum return_state = IMU660RA_STATE_NO_ERROR;
    imu_delay_ms(20);                                                           // 等待设备上电成功
    do{
        if( imu_assert(
                !imu_interface_init(),                                          // 如果没有异常 那么接口初始化返回为 0
                "IMU interface init error.",                                    // 输出预设报错信息
                ZF_FILE_MESSAGE, ZF_LINE_MESSAGE))
        {
            return_state = IMU660RA_STATE_INTERFACE_INIT_ERROR;
            break;
        }

        if( imu_assert(
                !imu660ra_expansion_ckeck_id(&imu_interface_default_obj),       // IMU660RA 自检 如果没有异常 那么接口初始化返回为 0
                "imu660ra self check error.",                                   // 输出预设报错信息
                ZF_FILE_MESSAGE, ZF_LINE_MESSAGE))
        {
            // 如果程序在输出了断言信息 并且提示出错位置在这里
            // 那么就是 IMU660RA 自检出错并超时退出了
            // 检查一下接线有没有问题 如果没问题可能就是坏了
            return_state = IMU660RA_STATE_SELF_CHECK_ERROR;
            break;
        }

        return_state = imu660ra_expansion_init(&imu_interface_default_obj);
    }while(0);
    if(return_state)
    {
        imu_interface_deinit();
    }
    return return_state;
}
// <<<<<<<<<<<<<<<<<<<<<<<<<<<<<<<<<<<<<<<<< Part   End <<<<<<<<<<<<<<<<<<<<<<<<<<<<<<<<<<<<<<<<<

const unsigned char imu660ra_config_file[8192] =
{
    0xc8, 0x2e, 0x00, 0x2e, 0x80, 0x2e, 0x3d, 0xb1, 0xc8, 0x2e, 0x00, 0x2e, 0x80, 0x2e, 0x91, 0x03,
    0x80, 0x2e, 0xbc, 0xb0, 0x80, 0x2e, 0xa3, 0x03, 0xc8, 0x2e, 0x00, 0x2e, 0x80, 0x2e, 0x00, 0xb0,
    0x50, 0x30, 0x21, 0x2e, 0x59, 0xf5, 0x10, 0x30, 0x21, 0x2e, 0x6a, 0xf5, 0x80, 0x2e, 0x3b, 0x03,
    0x00, 0x00, 0x00, 0x00, 0x08, 0x19, 0x01, 0x00, 0x22, 0x00, 0x75, 0x00, 0x00, 0x10, 0x00, 0x10,
    0xd1, 0x00, 0xb3, 0x43, 0x80, 0x2e, 0x00, 0xc1, 0x80, 0x2e, 0x00, 0xc1, 0x80, 0x2e, 0x00, 0xc1,
    0x80, 0x2e, 0x00, 0xc1, 0x80, 0x2e, 0x00, 0xc1, 0x80, 0x2e, 0x00, 0xc1, 0x80, 0x2e, 0x00, 0xc1,
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
    0x88, 0x01, 0x8a, 0x01, 0x8c, 0x01, 0x8f, 0x01, 0x8d, 0x01, 0x92, 0x01, 0x91, 0x01, 0xdd, 0x00,
    0x9f, 0x01, 0x7e, 0x01, 0xdb, 0x00, 0xb6, 0x01, 0x70, 0x69, 0x26, 0xd3, 0x9c, 0x07, 0x1f, 0x05,
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
};
