wdxzf/E-Race-AutoCar-/源码/user/user/MSPM0G3507_IMU660_Demo/BSP/headfile.h

#ifndef _HEADFILE_H_
#define _HEADFILE_H_

#include "stdio.h"
#include "board.h"
#include "ti_msp_dl_config.h"
#include "zf_device_imu660ra.h"
#include "motor.h"
#include "zf_common_function.h"
#include "A_imu66ra.h"
#include "Gray.h"
#include "My_PID.h"
#include "hled_key.h"

#include "encoder.h"

#include "bsp_at24c02.h"
#define dt 0.01
#endif
