wdxzf/E-Race-AutoCar-/(notices)

Notices in the files:
源码/user/user/MSPM0G3507_IMU660_Demo/zf_device/zf_device_imu660ra.c:
Copyright (c) 2022 SEEKFREE Öð·É¿Æ¼¼
